snqx-lqh/F1C100S_LearningRecord/01_Hardware/底板.pdf

# AFC01-S06FCA-00 GND GND

### SYS_3V3

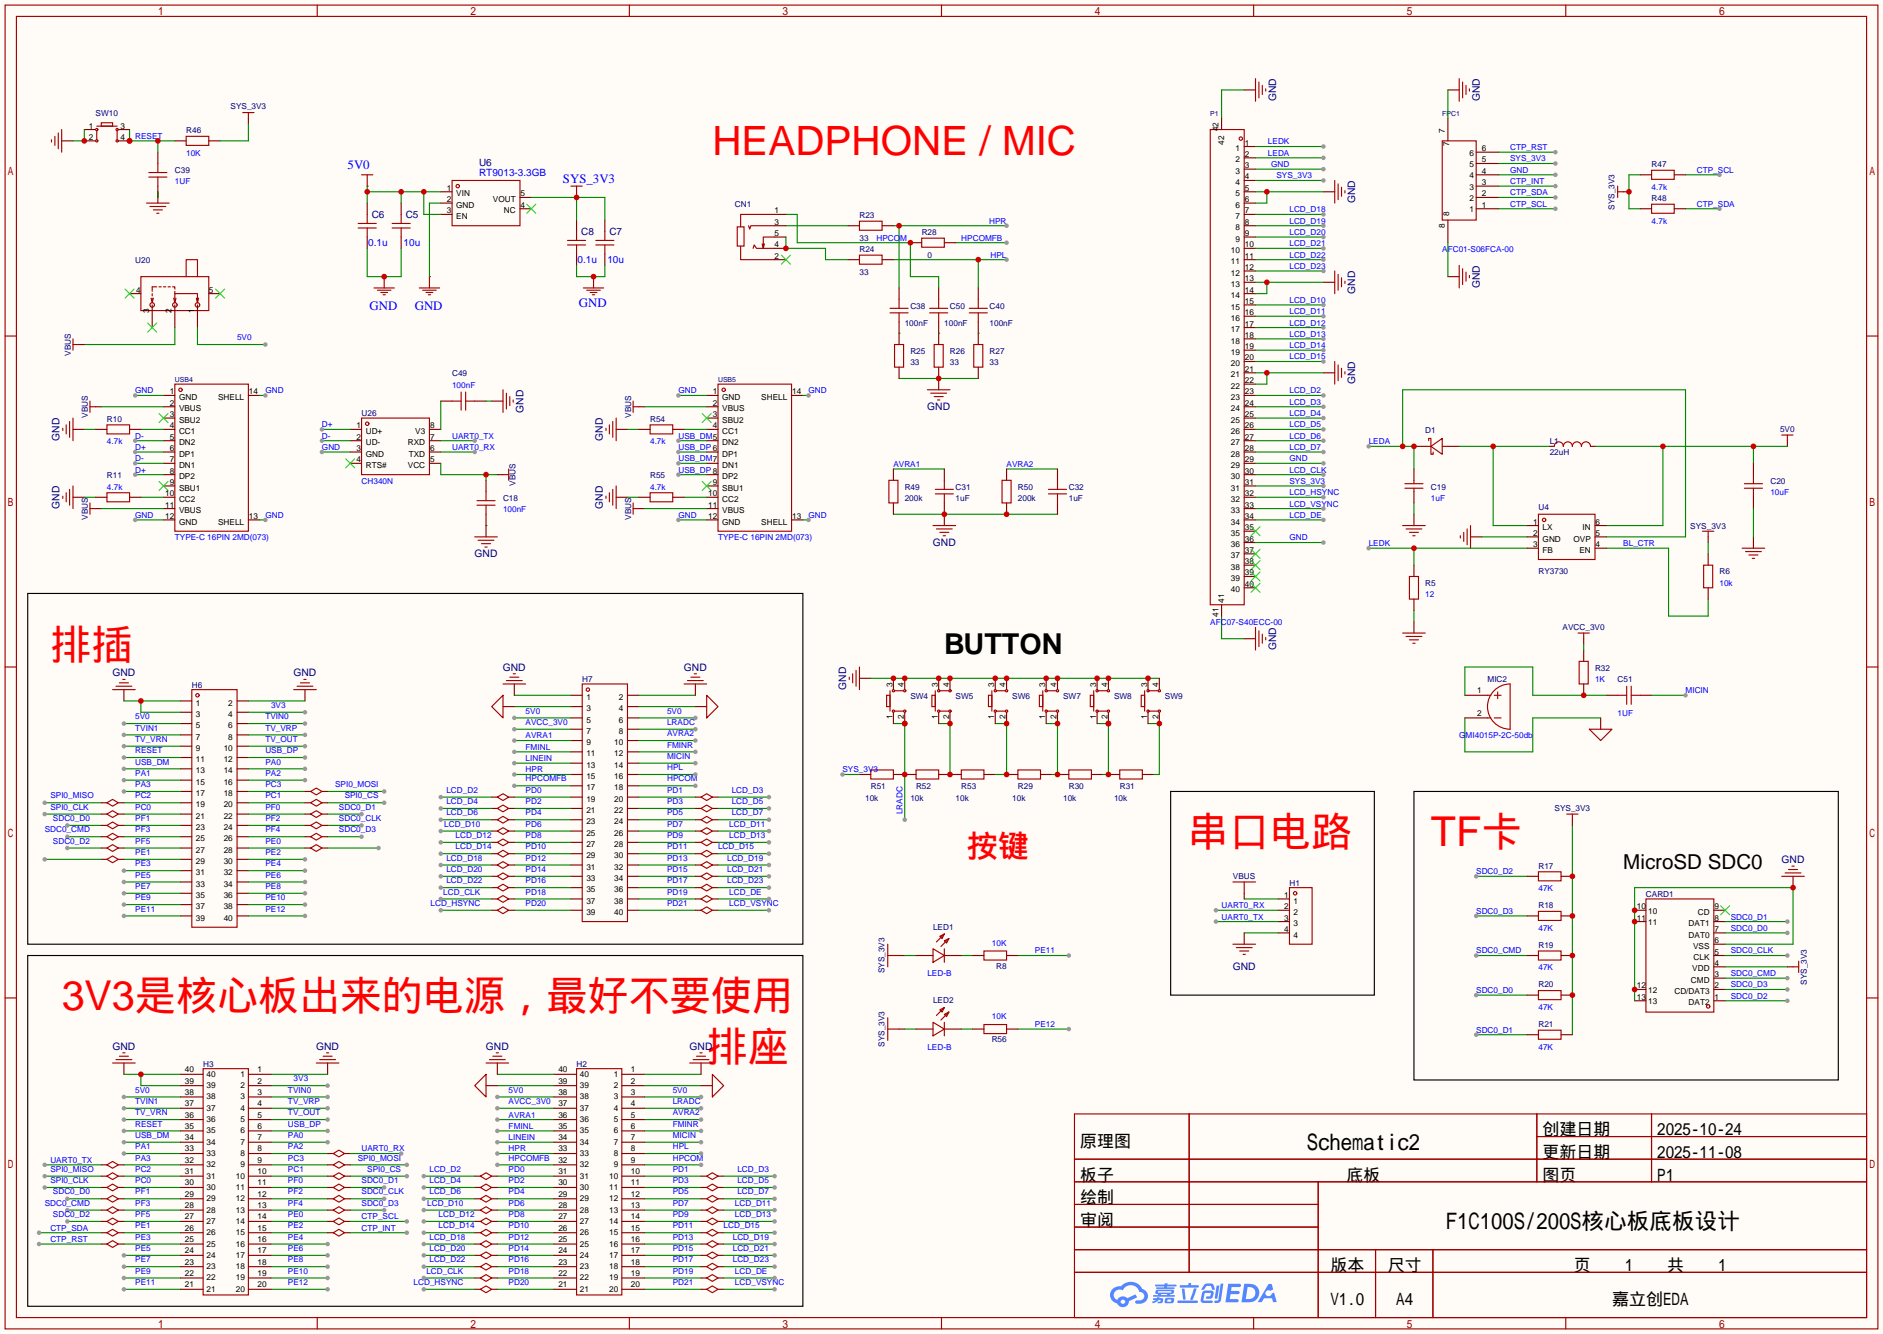
[picture p2: page 1]

原理图 | Schematic2 | 创建日期 | 2025-10-24

更新日期 | 2025-11-08

板子 | 底板 | 图页 | P1
绘制 | | F1C100S/200S核心板底板设计
审阅

V1.0 | A4 | 嘉立创EDA
