snqx-lqh/F1C100S_LearningRecord/01_Hardware/核心板V1.pdf

# 1V1 RESET

# power

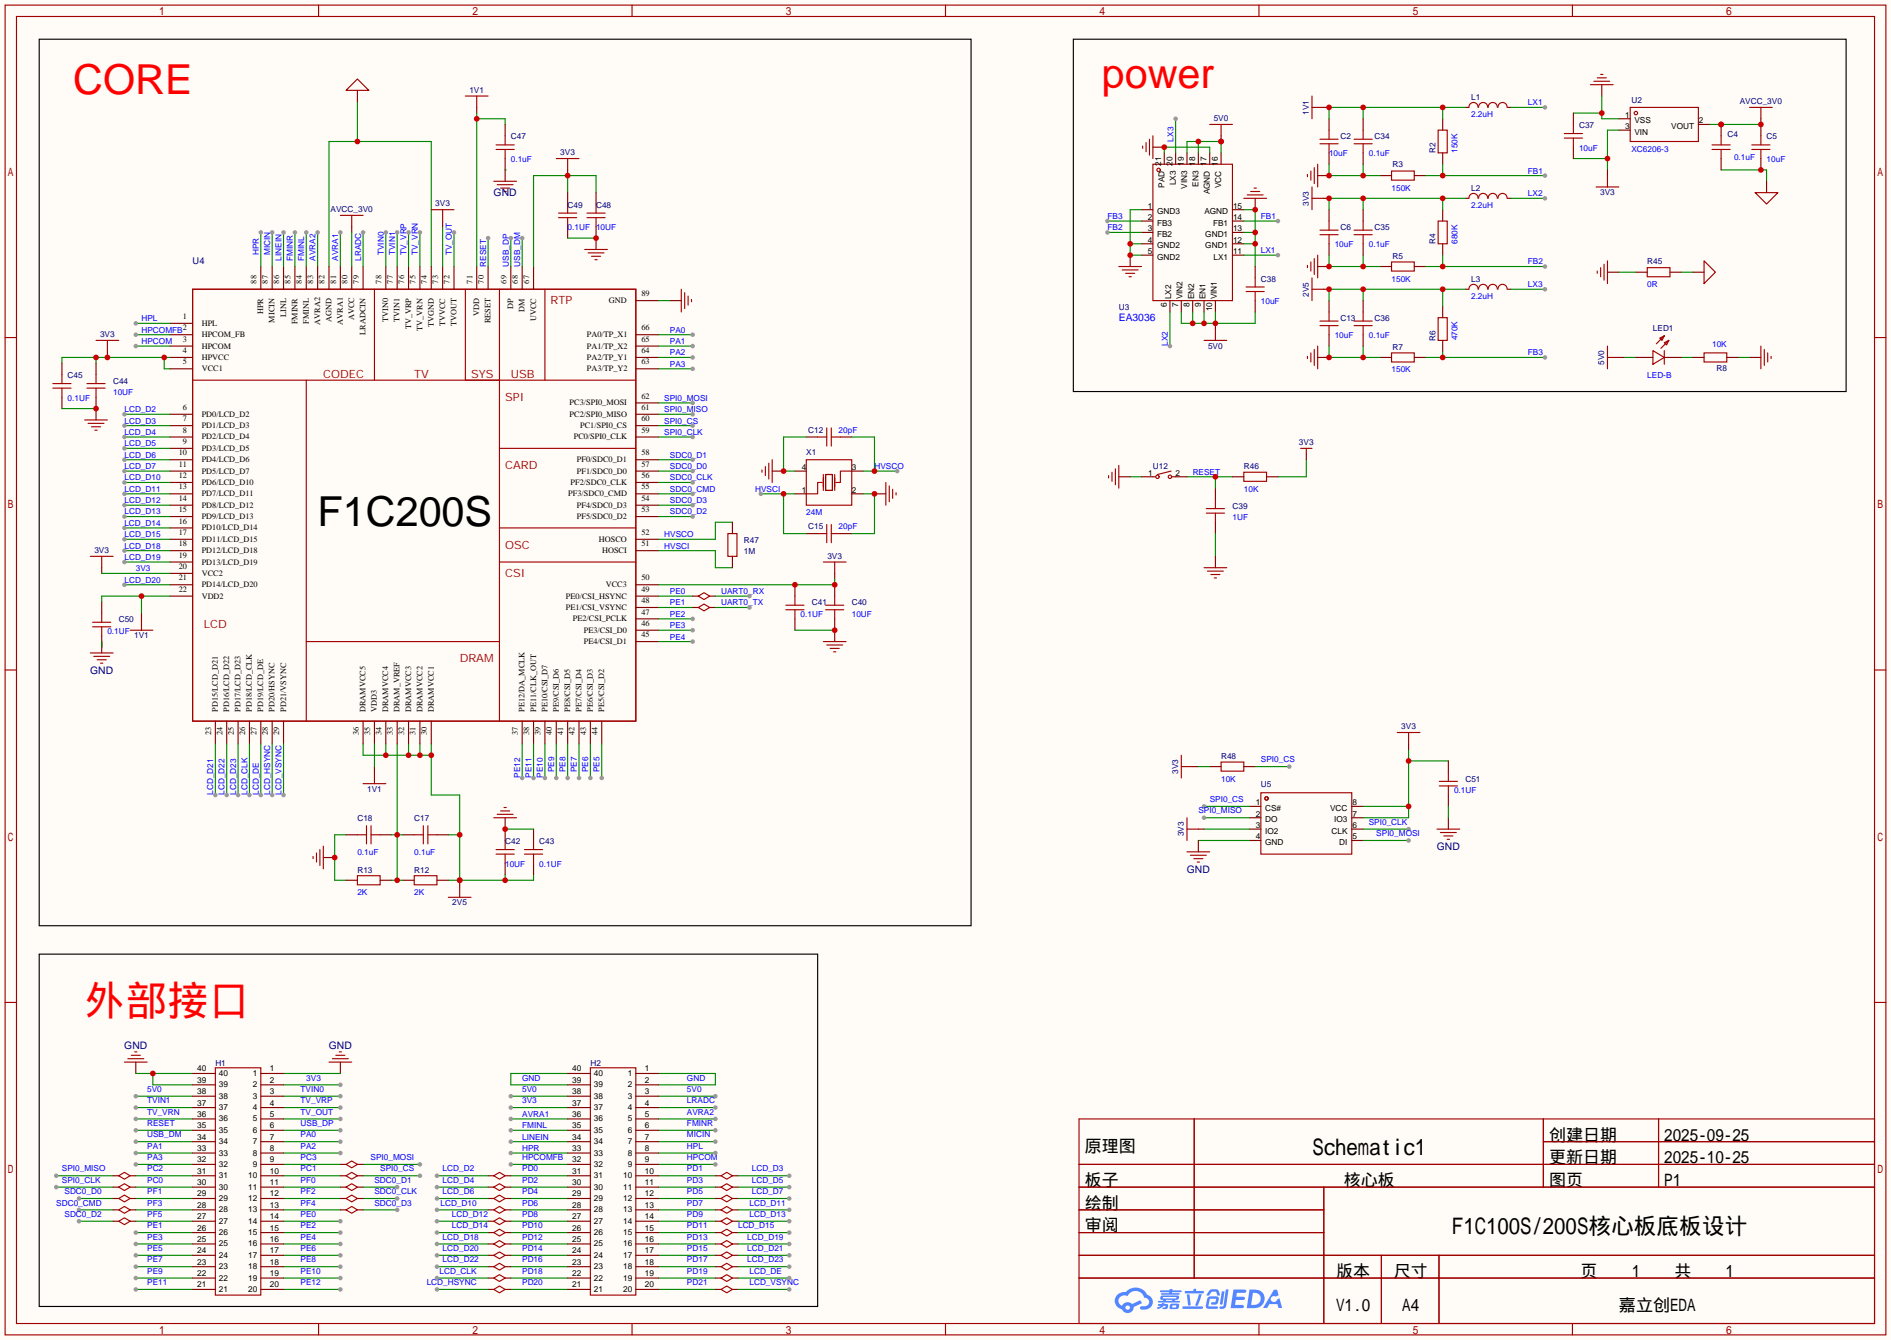
[picture p4: page 1]

原理图 | Schematic1 | 创建日期 | 2025-09-25

更新日期 | 2025-10-25

板子 | 核心板 | 图页 | P1
绘制 | | F1C100S/200S核心板底板设计
审阅

V1.0 | A4 | 嘉立创EDA
