snqx-lqh/F1C100S_LearningRecord/02_Firmware/CodeWithoutOS/bootloader/inc/spi_flash.h

#ifndef SPI_FLASH_H_
#define SPI_FLASH_H_

void spi_flash_init(void);
uint32_t spi_flash_read_id(void);

void spi_flash_write_enable(void);
void spi_flash_wait_ready(void);

uint8_t spi_flash_erase_full(void);
uint8_t spi_flash_erase_sector(uint32_t addr);
uint8_t spi_flash_read(uint32_t addr, uint8_t* data, uint32_t cnt);
uint8_t spi_flash_write(uint32_t addr, uint8_t* data, uint32_t cnt);
uint8_t spi_flash_write_sector(uint16_t sector_n, uint8_t* data);

void sys_dma_init(void);
int sys_spi_flash_read_dma(int addr, void * buf, int count);
void sys_dma_exit(void);

#endif /* SPI_FLASH_H_ */
